KoljaWindeler/CHIP_SALSA/README.md

please go to 
http://koljawindeler.github.io/CHIP_SALSA
