KoljaWindeler/CHIP_SALSA/schematics/3_Salsa_II_v3c/BOM.csv

Part/Designator | Manufacture Part Number/Seeed SKU | Quantity
u1 | atmega328p-au | 1
C1,C2,C3,C5,C12 | 08055C104KAT2A | 5
C4 | GRM32DR71E106KA12L | 1
D1,D2,D3 | ES2D | 3
LED1 | WS2812B | 1
Q2,Q3,Q4,Q5 | DMN6068SE-13 | 4
R1 | CRCW080510K0FKEA | 1
IC1 | aaL293DD | 1
LED2 | aa150080BS75000 | 1
IC2 | aa74HCT04D | 1
