KoljaWindeler/CHIP_SALSA/(threads)

Thread 1 (2016-08-13):

memory leak in firmware

TobbeJ, 2016-08-13:
there is a memory leak in the firmware that can cause the firmware to stop functioning properly.
see line: https://github.com/KoljaWindeler/CHIP_SALSA/blob/master/firmware/atmega328/atmega328.ino#L200
this pointer is never deleted.

so if you spam multiple config requests for a ws2812 pin eventually the firmware will run out of ram and bad things will happen.
