KoljaWindeler/CHIP_SALSA/schematics/3_Salsa_II_v3c/salsa_II_v3c_bot.pdf

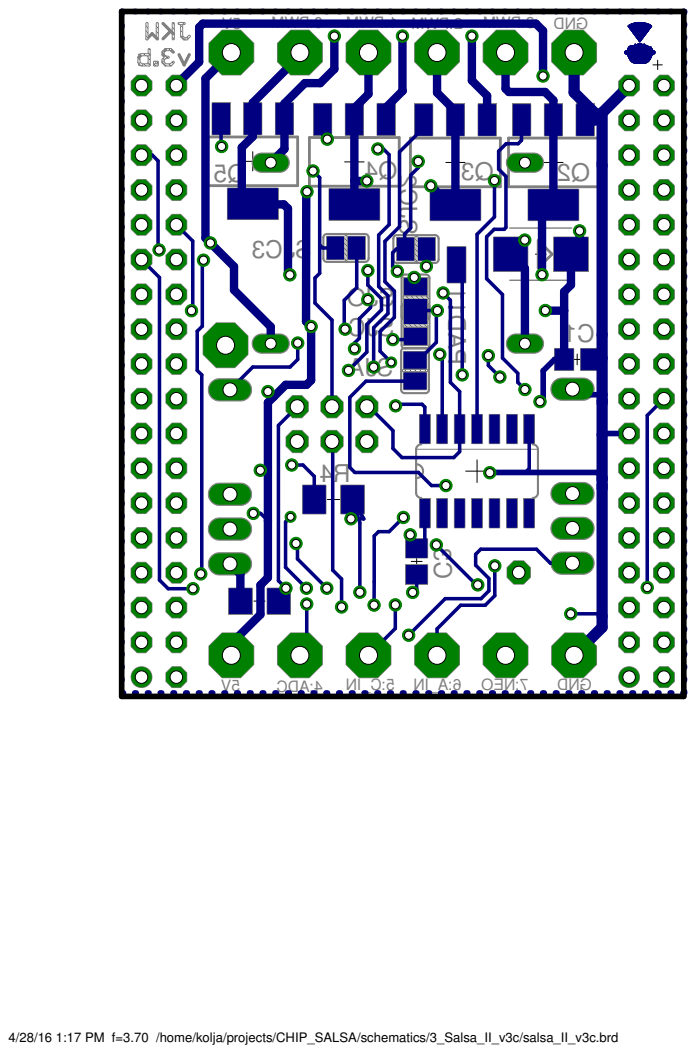
[picture p8: page 1]

4/28/16 1:17 PM f=3.70 /home/kolja/projects/CHIP_SALSA/schematics/3_Salsa_II_v3c/salsa_II_v3c.brd
