KoljaWindeler/CHIP_SALSA/schematics/3_Salsa_II_v3c/salsa_II_v3c_sch.pdf

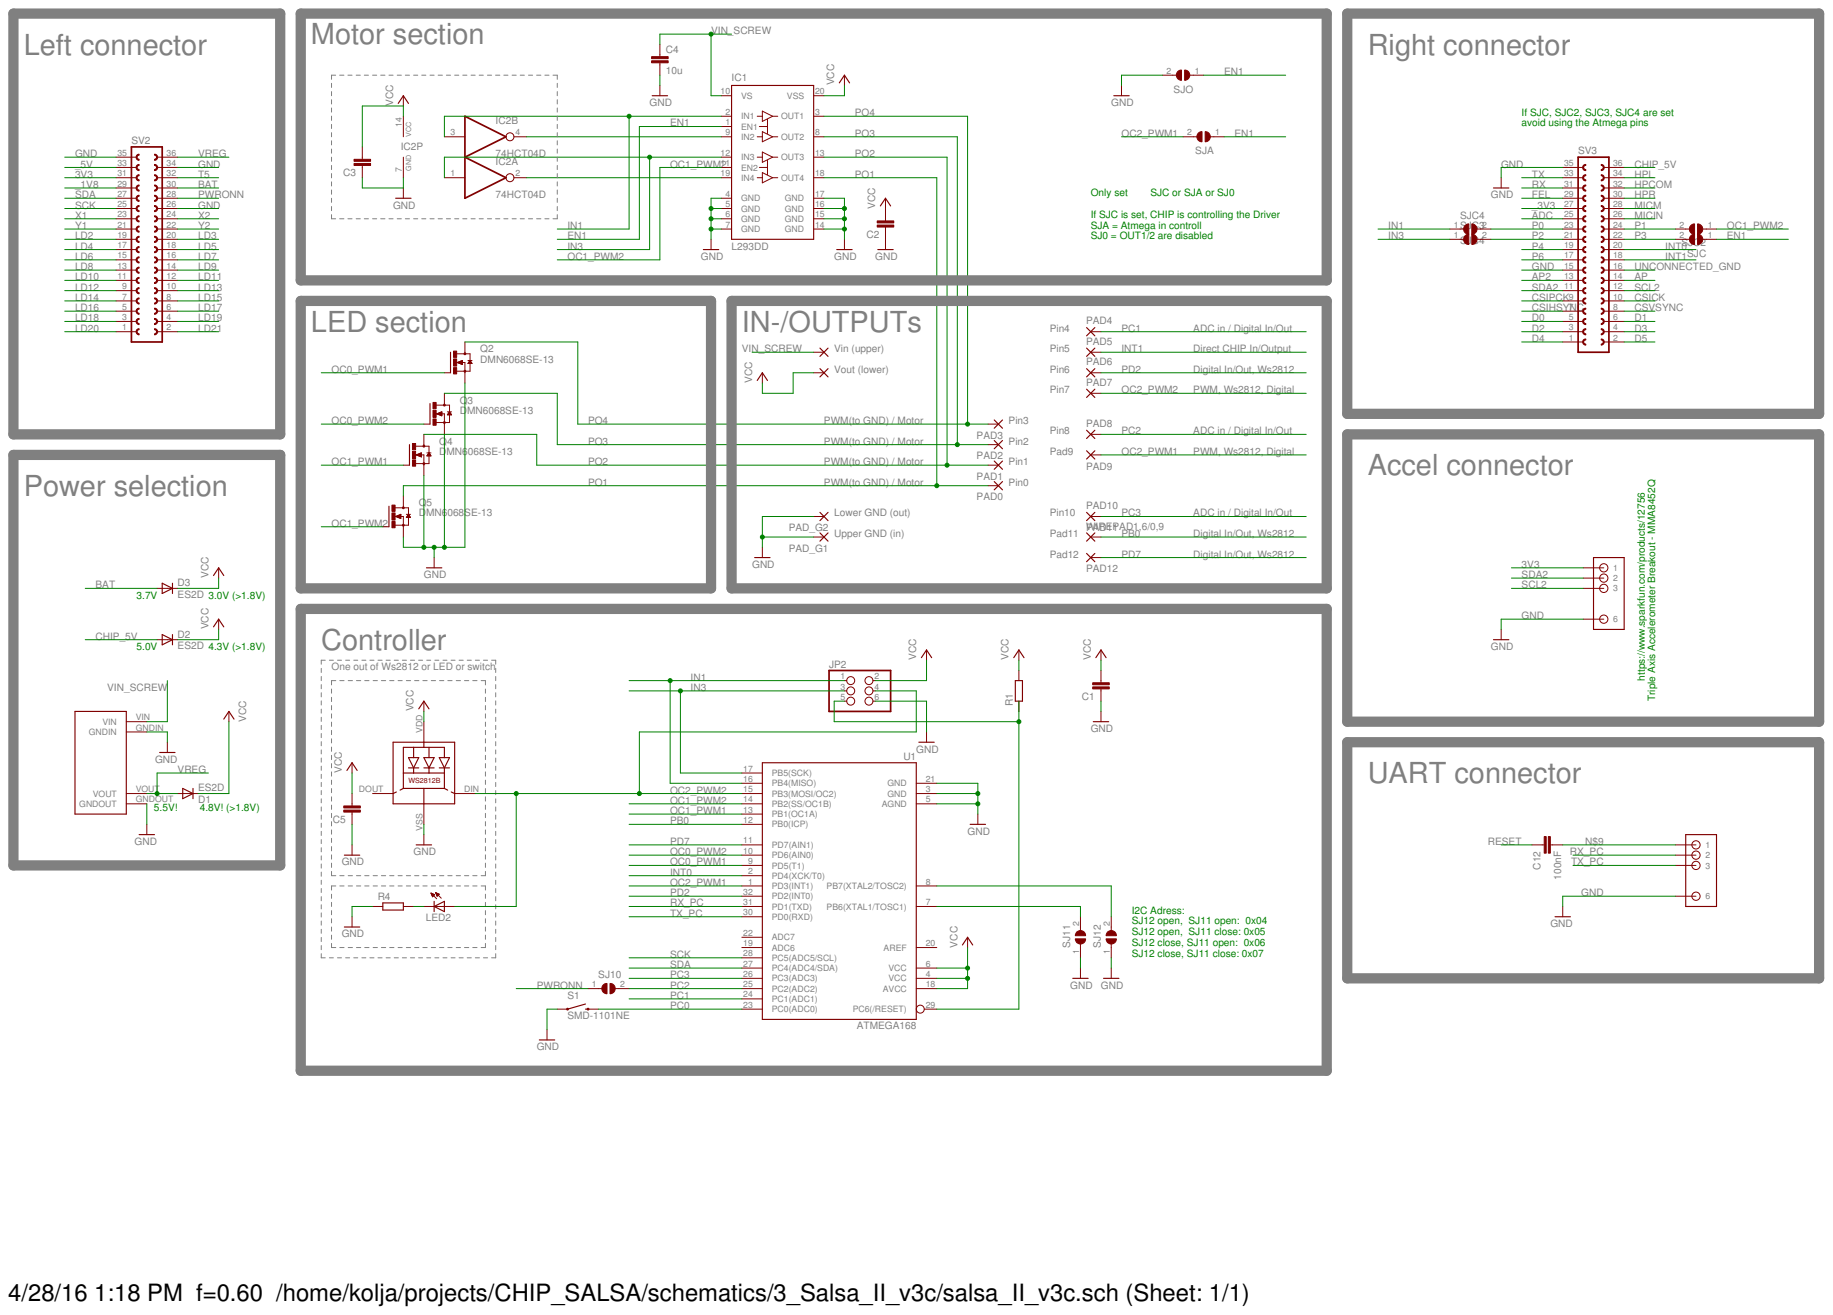
[picture p9: page 1]

If SJC, SJC2, SJC3, SJC4 are set avoid using the Atmega pins

If SJC is set, CHIP is controlling the Driver SJA = Atmega in controll SJ0 = OUT1/2 are disabled

ADC in / Digital In/Out
Direct CHIP In/Output Digital In/Out, Ws2812 PWM, Ws2812, Digital

ADC in / Digital In/Out PWM, Ws2812, Digital

https:/ www.sparkfun.com/products/12756 Triple Axis Accelerometer Breakout - MMA8452Q

Upper GND (in) Lower GND (out)

Digital In/Out, Ws2812

One out of Ws2812 or LED or switch

I2C Adress: SJ12 open, SJ11 open: 0x04 SJ12 open, SJ11 close: 0x05 SJ12 close, SJ11 open: 0x06 SJ12 close, SJ11 close: 0x07

4/28/16 1:18 PM f=0.60 /home/kolja/projects/CHIP_SALSA/schematics/3_Salsa_II_v3c/salsa_II_v3c.sch (Sheet: 1/1)
