KoljaWindeler/CHIP_SALSA/schematics/3_Salsa_II_v3c/salsa_II_v3c.brd

## EAGLE design schematics/3_Salsa_II_v3c/salsa_II_v3c.brd (2016-03-03)

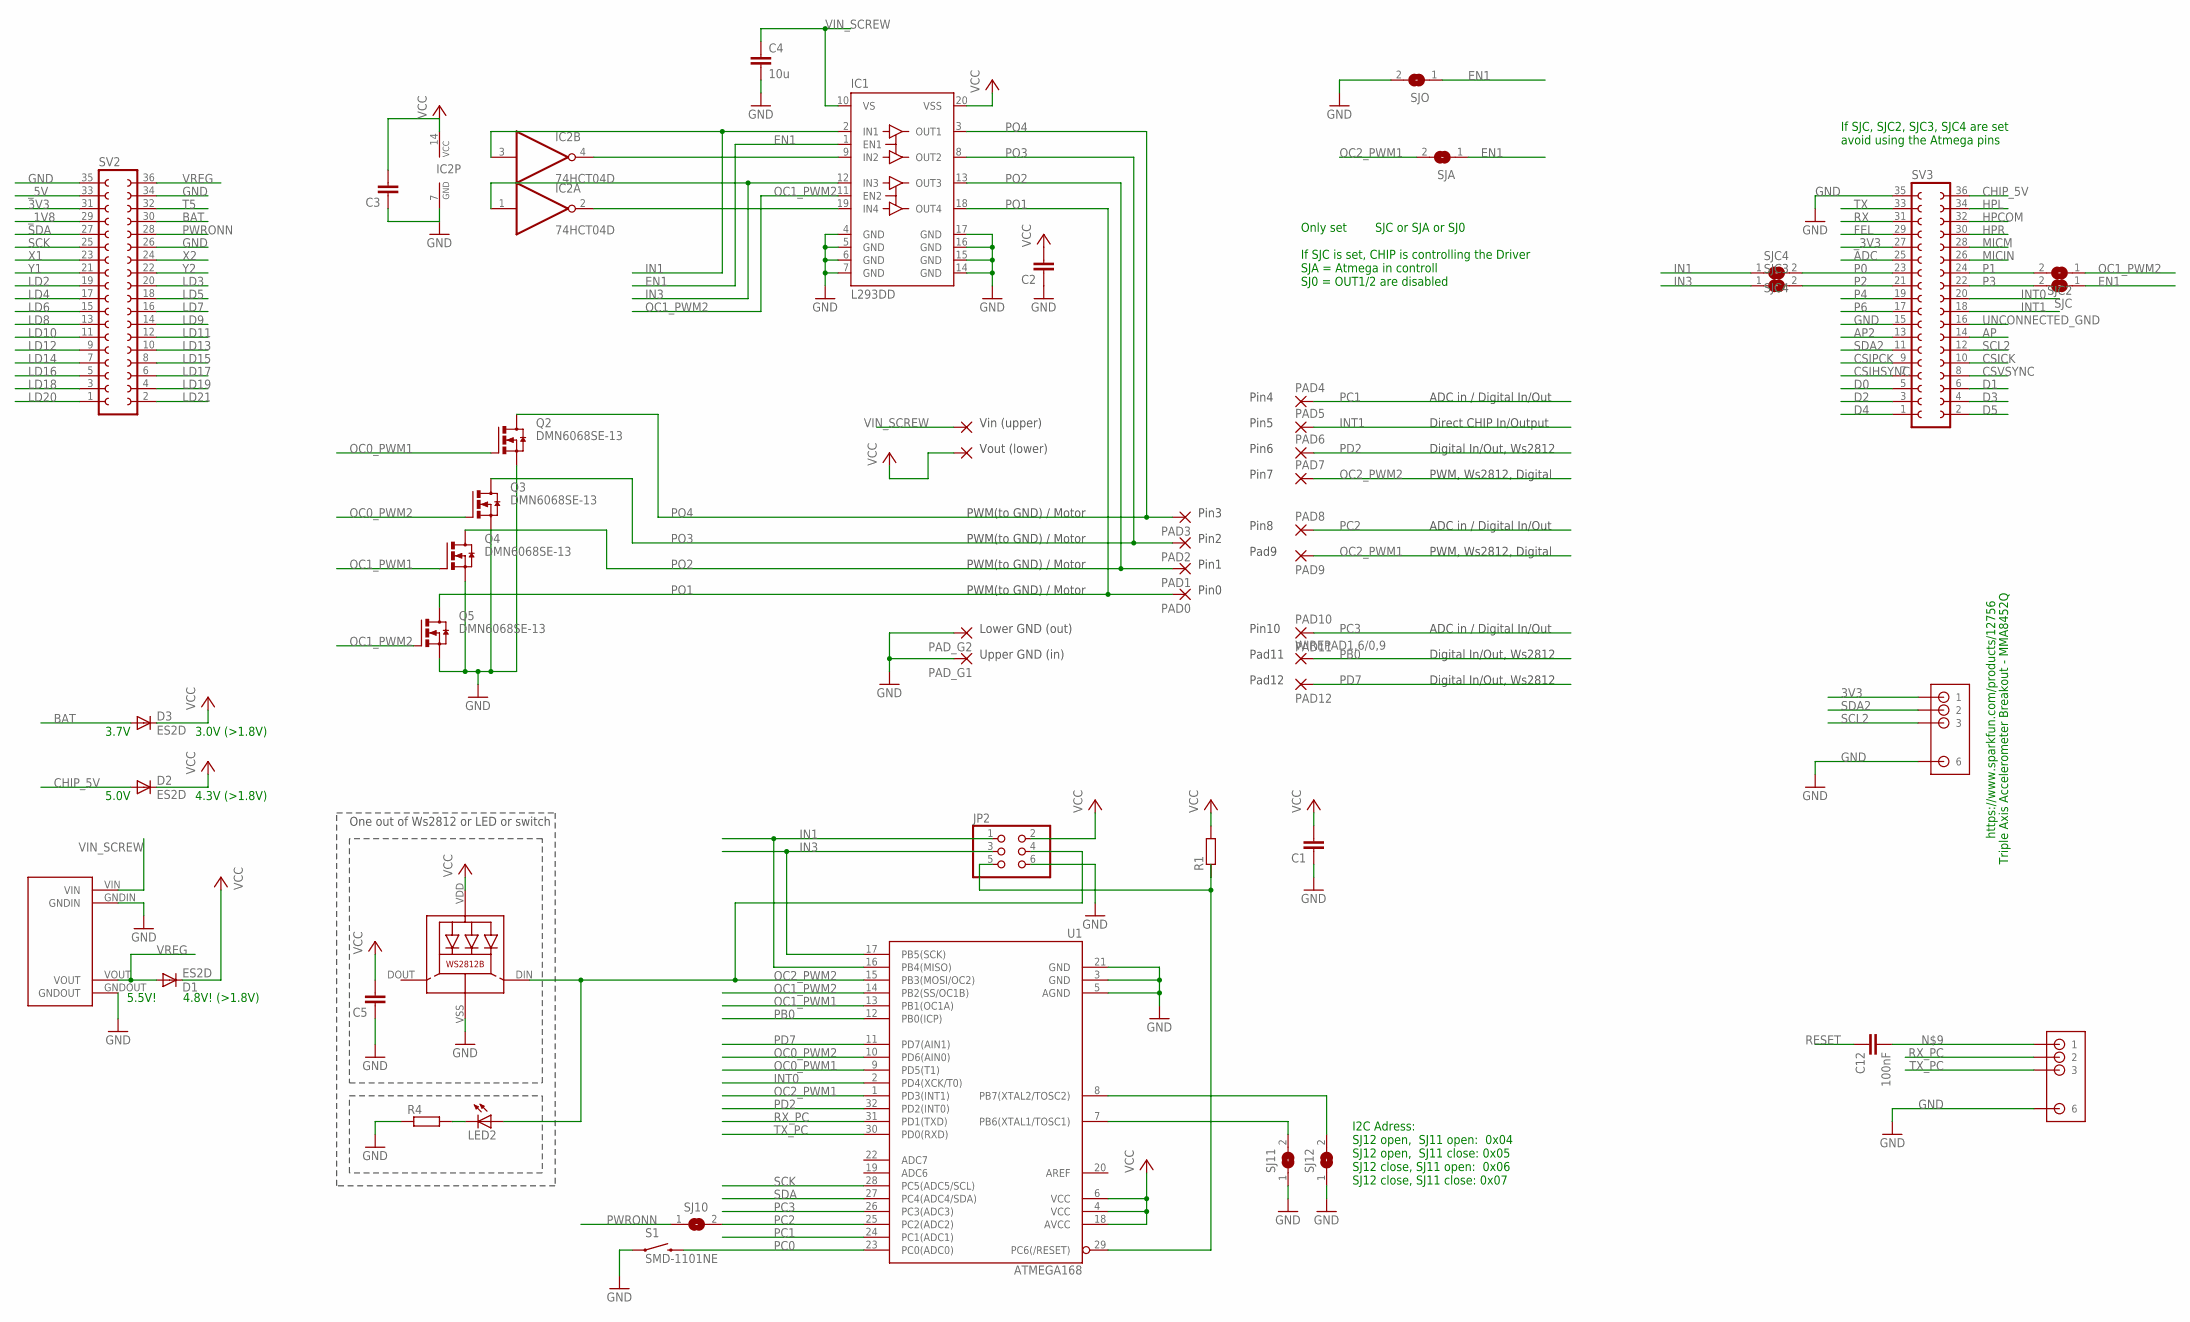
[picture p10: schematic salsa_II_v3c.sch]

Parts:
C1, C2, C3, C5: C-EUC0805; C0805
C4: 10u; C1210
C12: 100nF; C1206
D1, D2, D3: ES2D; SMB
IC1: L293DD; SO20
IC2: 74HCT04D; SO14
JP2: PINHD-2X3; 2X03
LED1: WS2812B
LED2: LEDCHIP-LED0805; CHIP-LED0805
PAD0, PAD1, PAD2, PAD3, PAD4, PAD5, PAD6, PAD7, PAD8, PAD17: 3,17/1,3
PAD9, PAD12: SMD2; SMD1,27-2,54
PAD10: WIREPAD1,6/0,9; 1,6/0,9
PAD11: WIREPADSMD1,27-254; SMD1,27-2,54
PAD_G1, PAD_G2: 3,17/1,3
PAD_VIN: 3,17/1,3
Q2, Q3, Q4, Q5: DMN6068SE-13; SOT223
R1: R-EU_M0805; M0805
R4: R-EU_M1206; M1206
S1: SMD-1101NE; TACTILE-SWITCH-1101NE
SJ10, SJ11, SJ12: SJ
SJA: SJ
SJC, SJC2, SJC3: SJ
SJC4: SJC4; SJ
SJO: SJ
SV2, SV3: FE18-2
U1: ATMEGA168; TQFP32-08
U$1: MP1584EN
U$3, U$4: 6_TO_4_HEADER

Connections:
3V3: SV2.31, U$4.1
ADC: SV3.25
AP: SV3.14
AP2: SV3.13
BAT: D3.A, SV2.30
CHIP_5V: D2.A, SV3.36
CSICK: SV3.10
CSIHSYNC: SV3.7
CSIPCK: SV3.9
CSVSYNC: SV3.8
D0: SV3.5
D1: SV3.6
D2: SV3.3
D3: SV3.4
D4: SV3.1
D5: SV3.2
EN1: IC1.1 (EN1), SJA.1, SJC.1, SJO.1
FEL: SV3.29
GND: C1.1, C2.1, C3.1, C4.2, C5.1, IC1.4 (GND), IC1.5 (GND), IC1.6 (GND), IC1.7 (GND), IC1.14 (GND), IC1.15 (GND), IC1.16 (GND), IC1.17 (GND), IC2.7 (GND), JP2.6, LED1.VSS (GND), PAD_G1.1, PAD_G2.1, Q2.3 (S), Q3.3 (S), Q4.3 (S), Q5.3 (S), R4.1, S1.P$1 (1), SJ11.1, SJ12.1, SJO.2, SV2.26, SV2.34, SV2.35, SV3.15, SV3.35, U1.3 (GND), U1.5 (AGND), U1.21 (GND), U$1.GNDIN, U$1.GNDOUT, U$3.6, U$4.6
HPCOM: SV3.32
HPL: SV3.34
HPR: SV3.30
IN1: IC1.2 (IN1), IC2.3 (I), JP2.1, SJC4.1, U1.16 (PB4(MISO))
IN3: IC1.12 (IN3), IC2.1 (I), JP2.3, SJC3.1, U1.17 (PB5(SCK))
INT0: SV3.20, U1.2 (PD4(XCK/T0))
INT1: PAD5.1, SV3.18
LD2: SV2.19
LD3: SV2.20
LD4: SV2.17
LD5: SV2.18
LD6: SV2.15
LD7: SV2.16
LD8: SV2.13
LD9: SV2.14
LD10: SV2.11
LD11: SV2.12
LD12: SV2.9
LD13: SV2.10
LD14: SV2.7
LD15: SV2.8
LD16: SV2.5
LD17: SV2.6
LD18: SV2.3
LD19: SV2.4
LD20: SV2.1
LD21: SV2.2
MICIN: SV3.26
MICM: SV3.28
unnamed: IC1.19 (IN4), IC2.2 (O)
unnamed: SJ11.2, U1.7 (PB6(XTAL1/TOSC1))
unnamed: SJ12.2, U1.8 (PB7(XTAL2/TOSC2))
unnamed: LED2.C, R4.2
unnamed: C12.2, U$3.1
unnamed: IC1.9 (IN2), IC2.4 (O)
OC0_PWM1: Q2.1 (G), U1.9 (PD5(T1))
OC0_PWM2: Q3.1 (G), U1.10 (PD6(AIN0))
OC1_PWM1: Q4.1 (G), U1.13 (PB1(OC1A))
OC1_PWM2: IC1.11 (EN2), Q5.1 (G), SJC2.1, U1.14 (PB2(SS/OC1B))
OC2_PWM1: PAD9.1, SJA.2, U1.1 (PD3(INT1))
OC2_PWM2: JP2.4, LED1.DIN (DI), LED2.A, PAD7.1, U1.15 (PB3(MOSI/OC2))
P0: SJC4.2, SV3.23
P1: SJC2.2, SV3.24
P2: SJC3.2, SV3.21
P3: SJC.2, SV3.22
P4: SV3.19
P6: SV3.17
PB0: PAD11.1, U1.12 (PB0(ICP))
PC0: S1.P$2 (2), U1.23 (PC0(ADC0))
PC1: PAD4.1, U1.24 (PC1(ADC1))
PC2: PAD8.1, SJ10.2, U1.25 (PC2(ADC2))
PC3: PAD10.1, U1.26 (PC3(ADC3))
PD2: PAD6.1, U1.32 (PD2(INT0))
PD7: PAD12.1, U1.11 (PD7(AIN1))
PO1: IC1.18 (OUT4), PAD0.1, Q5.2 (D), Q5.4 (D)
PO2: IC1.13 (OUT3), PAD1.1, Q4.2 (D), Q4.4 (D)
PO3: IC1.8 (OUT2), PAD2.1, Q3.2 (D), Q3.4 (D)
PO4: IC1.3 (OUT1), PAD3.1, Q2.2 (D), Q2.4 (D)
PWRONN: SJ10.1, SV2.28
RESET: C12.1, JP2.5, R1.1, U1.29 (PC6(/RESET))
RX: SV3.31
RX_PC: U1.31 (PD1(TXD)), U$3.2
SCK: SV2.25, U1.28 (PC5(ADC5/SCL))
SCL2: SV3.12, U$4.3
SDA: SV2.27, U1.27 (PC4(ADC4/SDA))
SDA2: SV3.11, U$4.2
T5: SV2.32
TX: SV3.33
TX_PC: U1.30 (PD0(RXD)), U$3.3
UNCONNECTED_GND: SV3.16
VCC: C1.2, C2.2, C3.2, C5.2, D1.C, D2.C, D3.C, IC1.20 (VSS), IC2.14 (VCC), JP2.2, LED1.VDD, PAD17.1, R1.2, U1.4 (VCC), U1.6 (VCC), U1.18 (AVCC)
VIN_SCREW: C4.1, IC1.10 (VS), PAD_VIN.1, U$1.VIN
VREG: D1.A, SV2.36, U$1.VOUT
X1: SV2.23
X2: SV2.24
Y1: SV2.21
Y2: SV2.22
_1V8: SV2.29
_3V3: SV3.27
_5V: SV2.33

Notes on the sheet:
https://www.sparkfun.com/products/12756
Triple Axis Accelerometer Breakout - MMA8452Q
Vin (upper)
Pin0
Pin1
Pin2
Pin3
Upper GND (in)
Lower GND (out)
Vout (lower)
Pin4
Pin5
Pad11
Pad12
Pad9
Pin6
Pin7
Pin8
Pin10
PWM(to GND) / Motor
ADC in / Digital In/Out
Direct CHIP In/Output
Digital In/Out, Ws2812
PWM, Ws2812, Digital
I2C Adress: SJ12 open, SJ11 open: 0x04 SJ12 open, SJ11 close: 0x05 SJ12 close, SJ11 open: 0x06 SJ12 close, SJ11 close: 0x07
Only set SJC or SJA or SJ0 If SJC is set, CHIP is controlling the Driver SJA = Atmega in controll SJ0 = OUT1/2 are disabled
If SJC, SJC2, SJC3, SJC4 are set avoid using the Atmega pins
One out of Ws2812 or LED or switch
5.5V!
4.8V! (>1.8V)
5.0V
4.3V (>1.8V)
3.0V (>1.8V)
3.7V

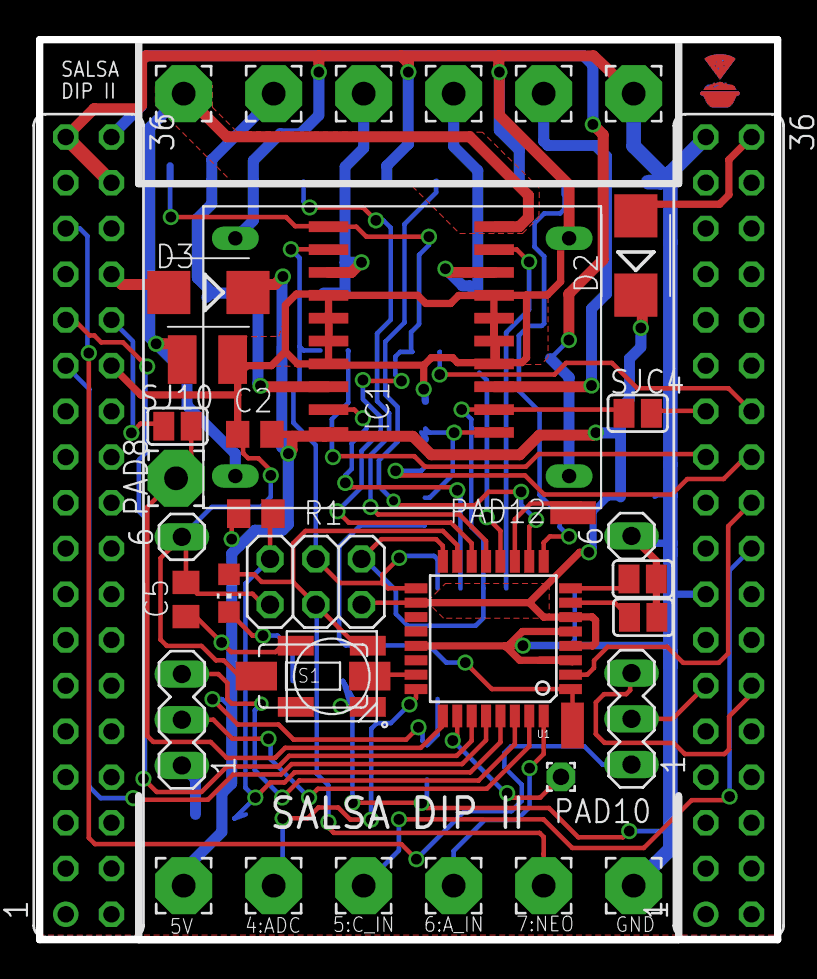
[picture p11: board salsa_II_v3c.brd from above]

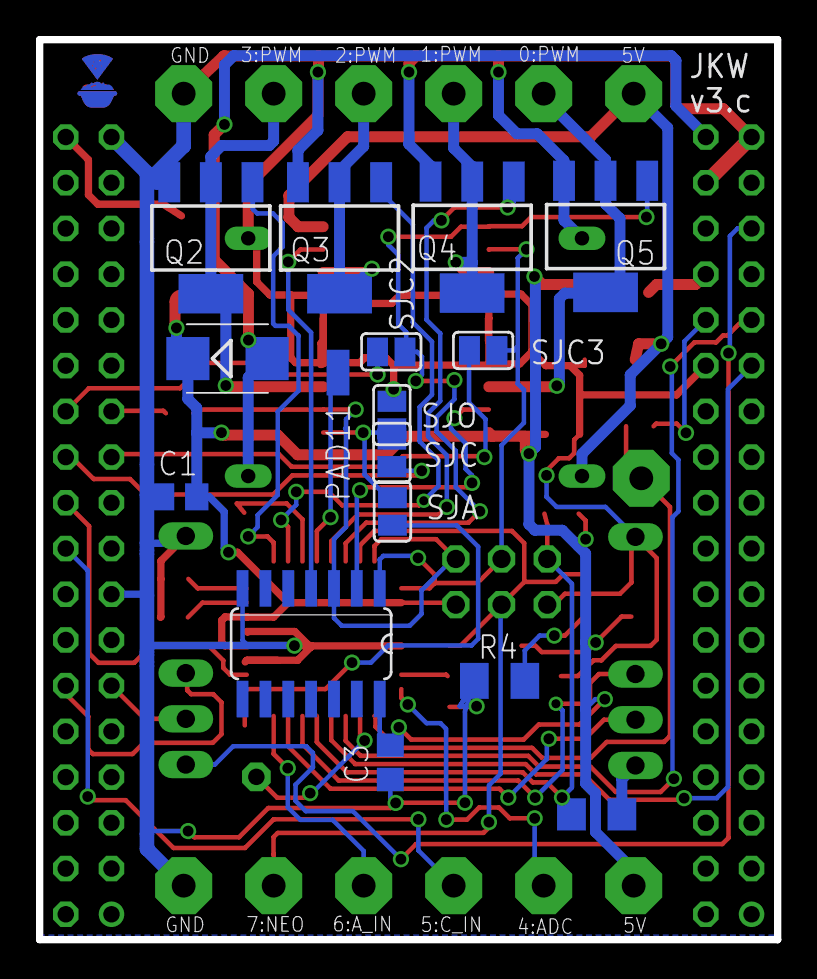
[picture p12: board salsa_II_v3c.brd from below]

Board: 2 copper layers, 41.0 x 50.0 mm, 55 parts (17 on the bottom side), 47 nets.

Other parts of the board:
U$2, U$5: LOGO
