KoljaWindeler/CHIP_SALSA/schematics/dev_versions/dev_v7/shield_v7.brd

## EAGLE design schematics/dev_versions/dev_v7/shield_v7.brd (2016-02-05, an earlier design)

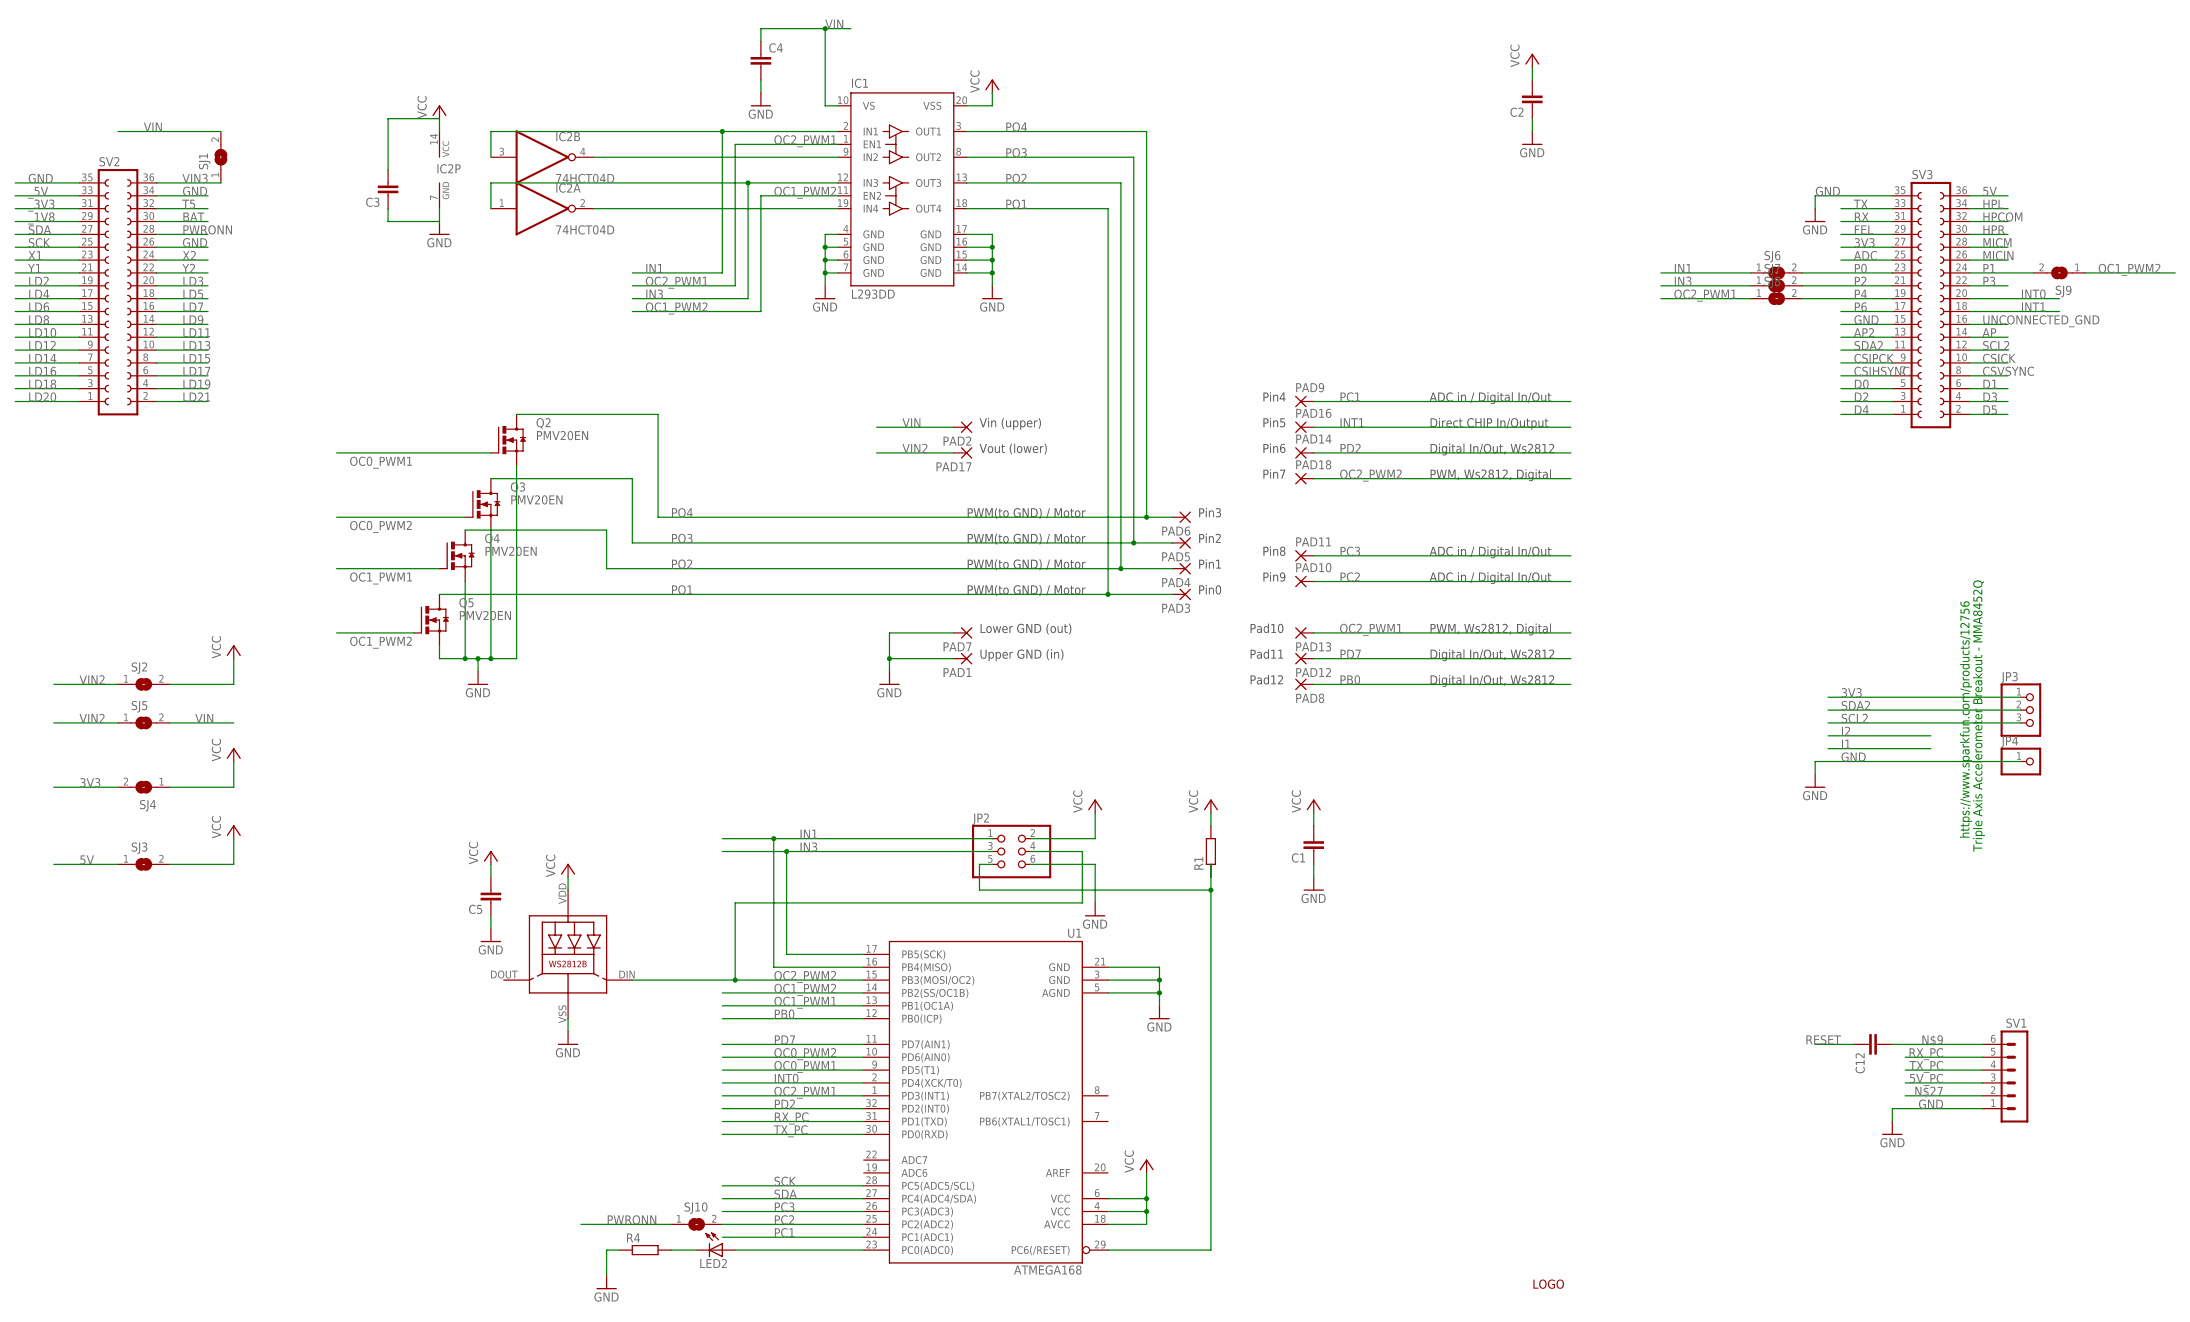
[picture p13: schematic shield_v7.sch]

Parts:
C1, C2, C3, C5: C-EUC0805; C0805
C4: C-EUC1210; C1210
C12: C-EUC1206; C1206
IC1: L293DD; SO20
IC2: 74HCT04D; SO14
JP2: PINHD-2X3; 2X03
JP3: PINHD-1X3; 1X03
JP4: PINHD-1X1; 1X01
LED1: WS2812B
LED2: LEDCHIP-LED0805; CHIP-LED0805
PAD1, PAD2, PAD3, PAD4, PAD5, PAD6, PAD7, PAD9, PAD10, PAD11, PAD14, PAD16, PAD17, PAD18: 3,17/1,3
PAD8: WIREPADSMD1,27-254; SMD1,27-2,54
PAD12, PAD13: SMD2; SMD1,27-2,54
Q2, Q3, Q4, Q5: PMV20EN; SOT223
R1, R4: R-EU_M1206; M1206
SJ1, SJ2, SJ3, SJ4, SJ5, SJ6, SJ7, SJ8, SJ9, SJ10: SJ
SV1: MA06-1
SV2, SV3: FE18-2
U1: ATMEGA168; TQFP32-08
U$2: LOGO

Connections:
3V3: JP3.1, SJ4.2, SV3.27
5V: SJ3.1, SV3.36
5V_PC: SV1.3
ADC: SV3.25
AP: SV3.14
AP2: SV3.13
BAT: SV2.30
CSICK: SV3.10
CSIHSYNC: SV3.7
CSIPCK: SV3.9
CSVSYNC: SV3.8
D0: SV3.5
D1: SV3.6
D2: SV3.3
D3: SV3.4
D4: SV3.1
D5: SV3.2
FEL: SV3.29
GND: C1.1, C2.1, C3.1, C4.2, C5.1, IC1.4 (GND), IC1.5 (GND), IC1.6 (GND), IC1.7 (GND), IC1.14 (GND), IC1.15 (GND), IC1.16 (GND), IC1.17 (GND), IC2.7 (GND), JP2.6, JP4.1, LED1.VSS (GND), PAD1.1, PAD7.1, Q2.3 (S), Q3.3 (S), Q4.3 (S), Q5.3 (S), R4.1, SV1.1, SV2.26, SV2.34, SV2.35, SV3.15, SV3.35, U1.3 (GND), U1.5 (AGND), U1.21 (GND)
HPCOM: SV3.32
HPL: SV3.34
HPR: SV3.30
IN1: IC1.2 (IN1), IC2.3 (I), JP2.1, SJ6.1, U1.16 (PB4(MISO))
IN3: IC1.12 (IN3), IC2.1 (I), JP2.3, SJ7.1, U1.17 (PB5(SCK))
INT0: SV3.20, U1.2 (PD4(XCK/T0))
INT1: PAD16.1, SV3.18
LD2: SV2.19
LD3: SV2.20
LD4: SV2.17
LD5: SV2.18
LD6: SV2.15
LD7: SV2.16
LD8: SV2.13
LD9: SV2.14
LD10: SV2.11
LD11: SV2.12
LD12: SV2.9
LD13: SV2.10
LD14: SV2.7
LD15: SV2.8
LD16: SV2.5
LD17: SV2.6
LD18: SV2.3
LD19: SV2.4
LD20: SV2.1
LD21: SV2.2
MICIN: SV3.26
MICM: SV3.28
unnamed: IC1.19 (IN4), IC2.2 (O)
unnamed: C12.2, SV1.6
unnamed: IC1.9 (IN2), IC2.4 (O)
unnamed: LED2.C, R4.2
unnamed: LED2.A, U1.23 (PC0(ADC0))
OC0_PWM1: Q2.1 (G), U1.9 (PD5(T1))
OC0_PWM2: Q3.1 (G), U1.10 (PD6(AIN0))
OC1_PWM1: Q4.1 (G), U1.13 (PB1(OC1A))
OC1_PWM2: IC1.11 (EN2), Q5.1 (G), SJ9.1, U1.14 (PB2(SS/OC1B))
OC2_PWM1: IC1.1 (EN1), PAD13.1, SJ8.1, U1.1 (PD3(INT1))
OC2_PWM2: JP2.4, LED1.DIN (DI), PAD18.1, U1.15 (PB3(MOSI/OC2))
P0: SJ6.2, SV3.23
P1: SJ9.2, SV3.24
P2: SJ7.2, SV3.21
P3: SV3.22
P4: SJ8.2, SV3.19
P6: SV3.17
PB0: PAD8.1, U1.12 (PB0(ICP))
PC1: PAD9.1, U1.24 (PC1(ADC1))
PC2: PAD10.1, SJ10.2, U1.25 (PC2(ADC2))
PC3: PAD11.1, U1.26 (PC3(ADC3))
PD2: PAD14.1, U1.32 (PD2(INT0))
PD7: PAD12.1, U1.11 (PD7(AIN1))
PO1: IC1.18 (OUT4), PAD3.1, Q5.2 (D), Q5.4 (D)
PO2: IC1.13 (OUT3), PAD4.1, Q4.2 (D), Q4.4 (D)
PO3: IC1.8 (OUT2), PAD5.1, Q3.2 (D), Q3.4 (D)
PO4: IC1.3 (OUT1), PAD6.1, Q2.2 (D), Q2.4 (D)
PWRONN: SJ10.1, SV2.28
RESET: C12.1, JP2.5, R1.1, U1.29 (PC6(/RESET))
RX: SV3.31
RX_PC: SV1.5, U1.31 (PD1(TXD))
SCK: SV2.25, U1.28 (PC5(ADC5/SCL))
SCL2: JP3.3, SV3.12
SDA: SV2.27, U1.27 (PC4(ADC4/SDA))
SDA2: JP3.2, SV3.11
T5: SV2.32
TX: SV3.33
TX_PC: SV1.4, U1.30 (PD0(RXD))
UNCONNECTED_GND: SV3.16
VCC: C1.2, C2.2, C3.2, C5.2, IC1.20 (VSS), IC2.14 (VCC), JP2.2, LED1.VDD, R1.2, SJ2.2, SJ3.2, SJ4.1, U1.4 (VCC), U1.6 (VCC), U1.18 (AVCC)
VIN: C4.1, IC1.10 (VS), PAD2.1, SJ1.2, SJ5.2
VIN2: PAD17.1, SJ2.1, SJ5.1
VIN3: SJ1.1, SV2.36
X1: SV2.23
X2: SV2.24
Y1: SV2.21
Y2: SV2.22
_1V8: SV2.29
_3V3: SV2.31
_5V: SV2.33

Notes on the sheet:
https://www.sparkfun.com/products/12756
Triple Axis Accelerometer Breakout - MMA8452Q
Vin (upper)
Pin0
Pin1
Pin2
Pin3
Upper GND (in)
Lower GND (out)
Vout (lower)
Pin4
Pin5
Pad12
Pad11
Pad10
Pin6
Pin7
Pin9
Pin8
PWM(to GND) / Motor
ADC in / Digital In/Out
Direct CHIP In/Output
Digital In/Out, Ws2812
PWM, Ws2812, Digital

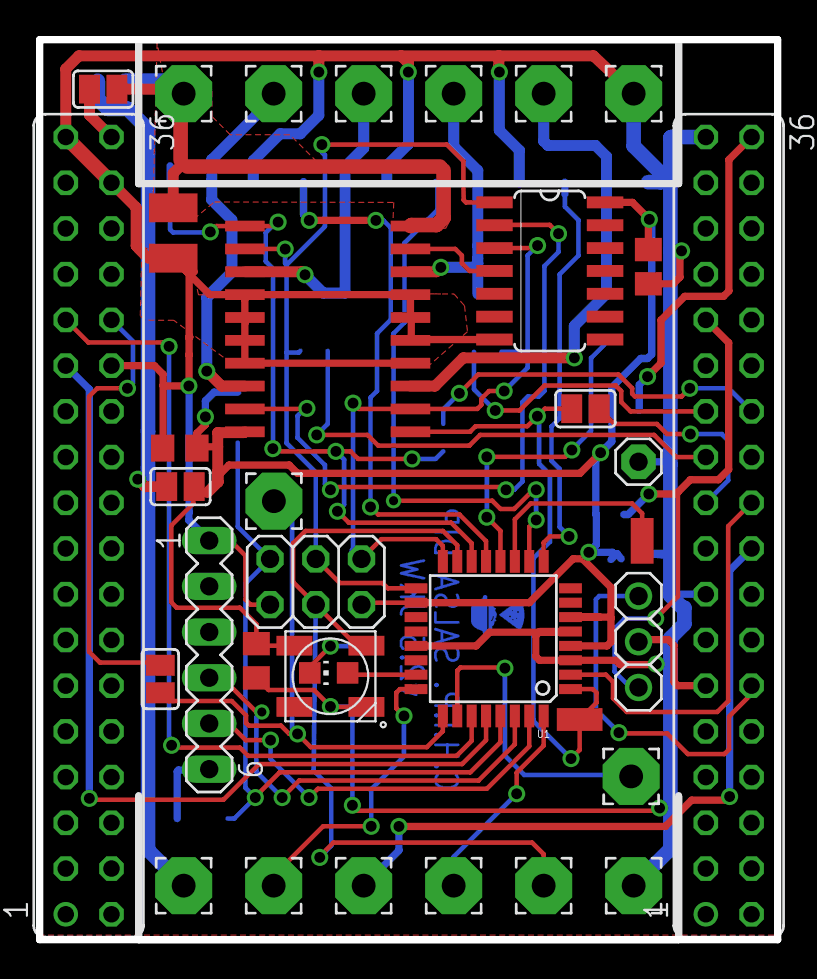
[picture p14: board shield_v7.brd from above]

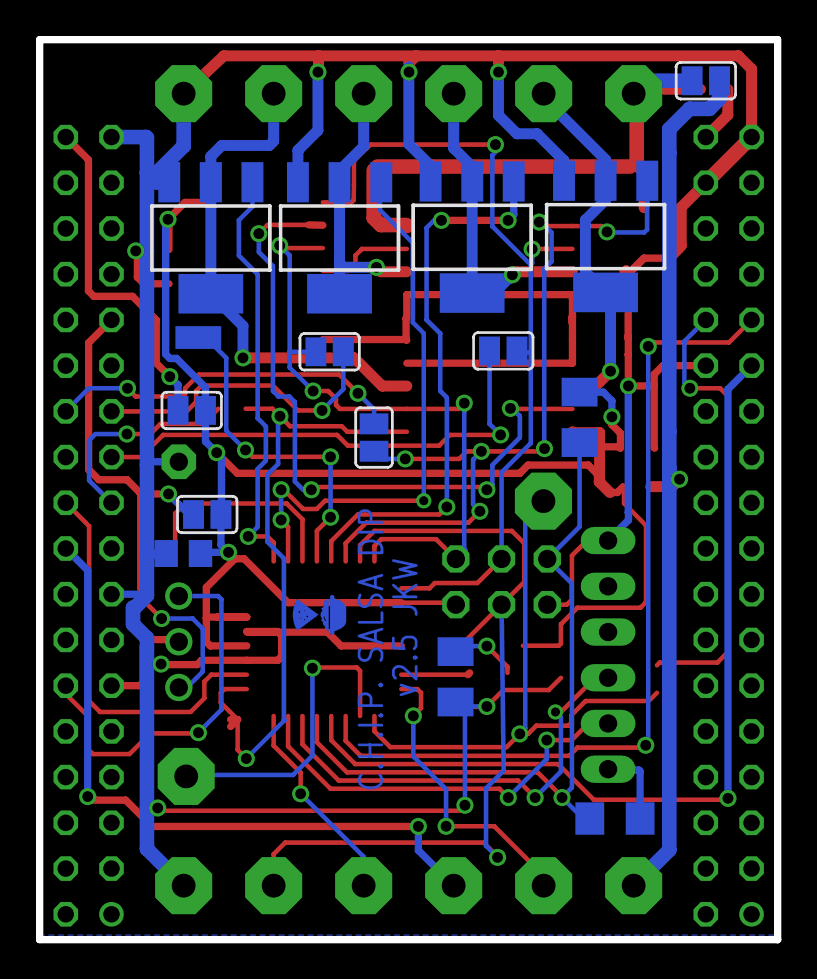
[picture p15: board shield_v7.brd from below]

Board: 2 copper layers, 41.0 x 50.0 mm, 51 parts (15 on the bottom side), 44 nets.
