KoljaWindeler/CHIP_SALSA/schematics/dev_versions/dev_v1/shield.brd

## EAGLE design schematics/dev_versions/dev_v1/shield.brd (2016-01-03, an earlier design)

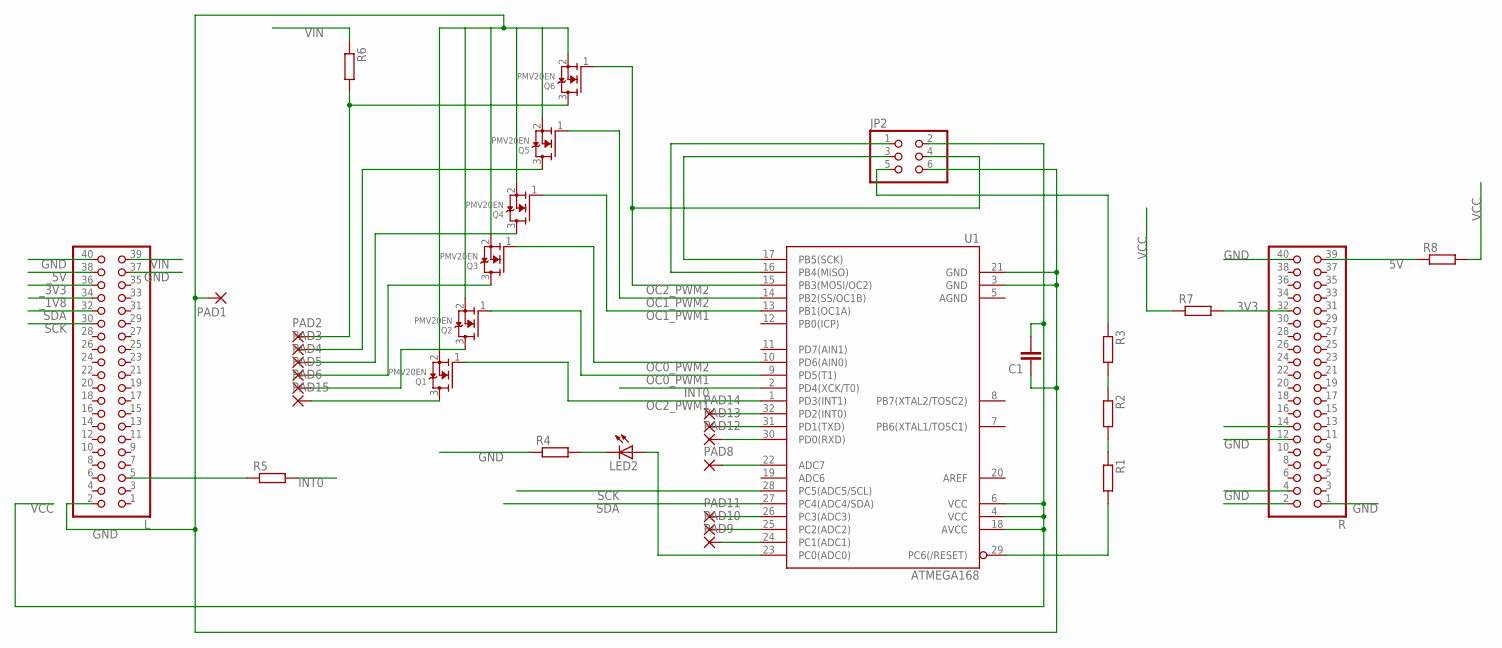
[picture p16: schematic shield.sch]

Parts:
C1: C-EUC0805; C0805
JP2: PINHD-2X3; 2X03
L: PINHD-2X20; 2X20
LED2: LEDCHIP-LED0805; CHIP-LED0805
PAD1, PAD2, PAD3, PAD4, PAD5, PAD6, PAD8, PAD9, PAD10, PAD11, PAD12, PAD13, PAD14, PAD15: 2,54/0,9
Q1, Q2, Q3, Q4, Q5, Q6: PMV20EN; SOT23
R: PINHD-2X20; 2X20
R1, R2, R3, R4, R5, R6: R-EU_M1206; M1206
R7, R8: R-EU_M0805; M0805
U1: ATMEGA168; TQFP32-08

Connections:
3V3: R.32, R7.2
5V: R.39, R8.1
GND: C1.1, JP2.6, L.2, L.37, L.40, PAD1.1, Q1.2 (S), Q2.2 (S), Q3.2 (S), Q4.2 (S), Q5.2 (S), Q6.2 (S), R.1, R.4, R.12, R.40, R4.1, U1.3 (GND), U1.21 (GND)
INT0: R5.2, U1.2 (PD4(XCK/T0))
unnamed: R1.2, U1.29 (PC6(/RESET))
unnamed: JP2.1, U1.16 (PB4(MISO))
unnamed: JP2.3, U1.17 (PB5(SCK))
unnamed: PAD15.1, Q1.3 (D)
unnamed: PAD6.1, Q2.3 (D)
unnamed: PAD5.1, Q3.3 (D)
unnamed: PAD4.1, Q4.3 (D)
unnamed: PAD3.1, Q5.3 (D)
unnamed: PAD2.1, Q6.3 (D), R6.2
unnamed: JP2.5, R3.1
unnamed: PAD12.1, U1.30 (PD0(RXD))
unnamed: PAD13.1, U1.31 (PD1(TXD))
unnamed: PAD14.1, U1.32 (PD2(INT0))
unnamed: PAD8.1, U1.22 (ADC7)
unnamed: PAD9.1, U1.24 (PC1(ADC1))
unnamed: PAD10.1, U1.25 (PC2(ADC2))
unnamed: PAD11.1, U1.26 (PC3(ADC3))
unnamed: R1.1, R2.2
unnamed: R2.1, R3.2
unnamed: LED2.C, R4.2
unnamed: L.5, R5.1
unnamed: LED2.A, U1.23 (PC0(ADC0))
OC0_PWM1: Q2.1 (G), U1.9 (PD5(T1))
OC0_PWM2: Q3.1 (G), U1.10 (PD6(AIN0))
OC1_PWM1: Q4.1 (G), U1.13 (PB1(OC1A))
OC1_PWM2: Q5.1 (G), U1.14 (PB2(SS/OC1B))
OC2_PWM1: Q1.1 (G), U1.1 (PD3(INT1))
OC2_PWM2: JP2.4, Q6.1 (G), U1.15 (PB3(MOSI/OC2))
SCK: L.30, U1.28 (PC5(ADC5/SCL))
SDA: L.32, U1.27 (PC4(ADC4/SDA))
VCC: C1.2, JP2.2, R7.1, R8.2, U1.4 (VCC), U1.6 (VCC), U1.18 (AVCC)
VIN: L.39, R6.1
_1V8: L.34
_3V3: L.36
_5V: L.38

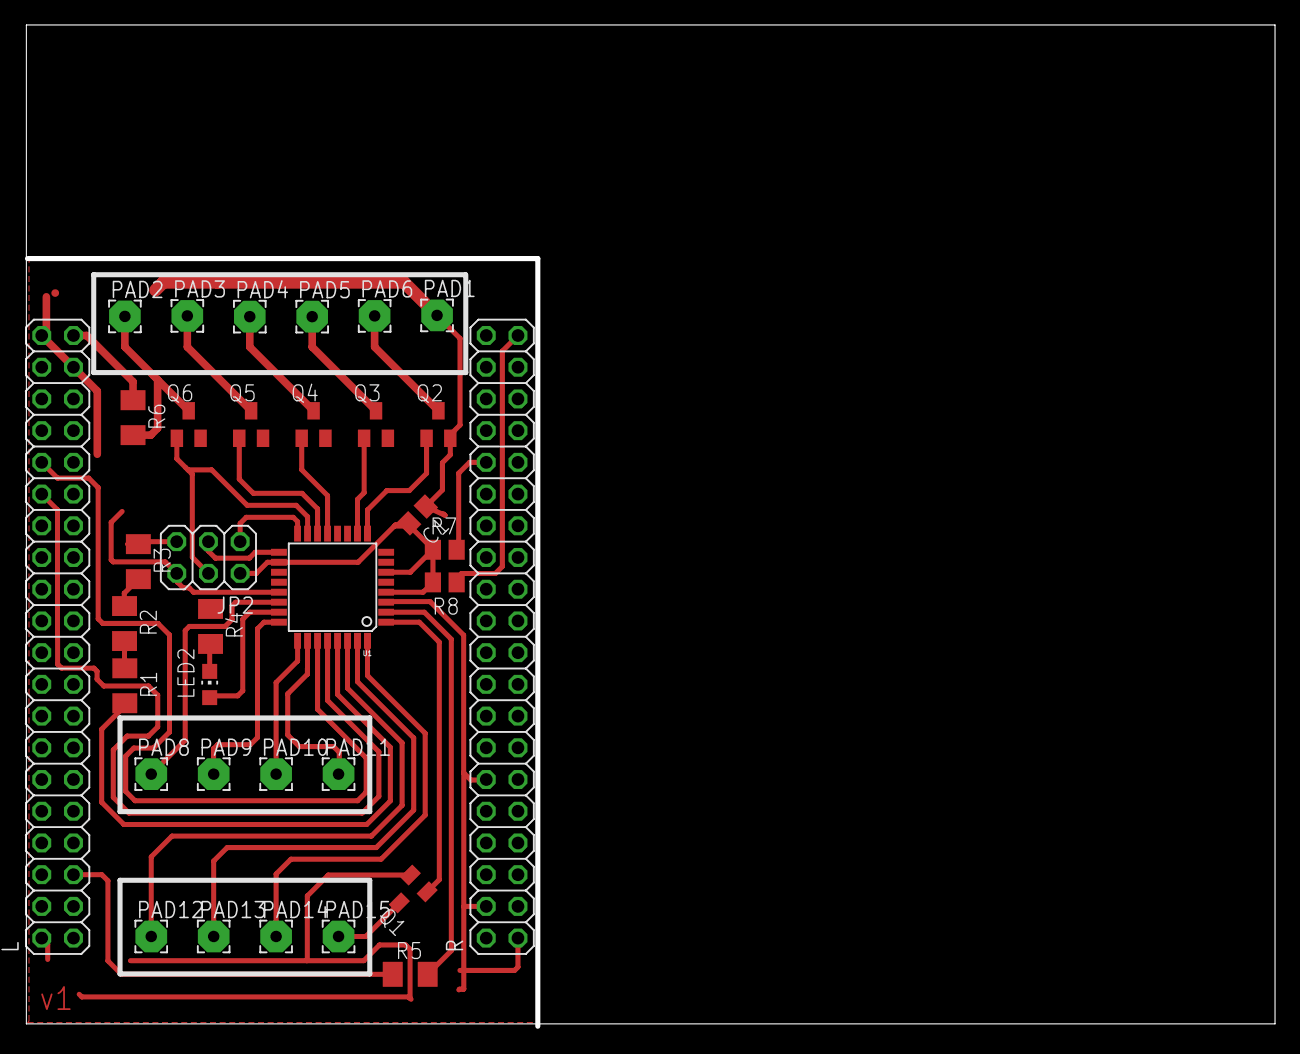
[picture p17: board shield.brd from above]

Board: 2 copper layers, 100.0 x 80.0 mm, 34 parts (0 on the bottom side), 36 nets.
