KoljaWindeler/CHIP_SALSA/python/lib_set_digital.py

import time
import arduino_bridge

pin=1

arduino = arduino_bridge.connection()
arduino.setup_digital_output(pin)

while(1):
	arduino.digitalWrite(pin,1)
	print("GPIO pin "+str(pin)+" set HIGH")
	time.sleep(1)
	arduino.digitalWrite(pin,0)
	print("GPIO pin "+str(pin)+" set HIGH")
	time.sleep(1)
