KoljaWindeler/CHIP_SALSA/(commit log)

2016-01-03 added 3.3/5V, a chargin pin and fixed chip layout
    [shield.brd, shield.sch]
2016-01-14 added all leds one color
2016-01-14 removed pin 12 from ws2812, N-Mosfet will avoid Ws2812 cmds
2016-01-15 multi ws2812 support
    [shield.brd, shield.sch]
2016-01-19 added reset cap
    [shield_v3.brd, shield_v3.sch]
2016-01-25 added i2c lib install script
2016-01-25 Added jumper to drive atmega via Vin or CHIP 5V or CHIP3.3V
    [shield_v3.brd, shield_v3.sch]
2016-01-26 first round of fixes
    [arduino_bridge.py, lib_analog_read.py, lib_set_digital.py, lib_ws2812_rainbow.py]
2016-01-26 added todos as reminder for new board
2016-01-26 fixed poor man rainbow to full 3*255 colors
    [lib_ws2812_rainbow.py]
2016-01-27 added the motor driver and inverter to the pwm shield
    [shield_v4.brd, shield_v4.sch]
2016-01-29 added version 2.2 with solder jumper from CHIP GPIO to Motor driver
    [shield_v5.brd, shield_v5.sch]
2016-01-29 updated routing
    [shield_v5.brd]
2016-01-31 copied digital pin settings to arduino file
2016-01-31 rerouting to fix osh DRU issues
    [shield_v5.brd]
2016-01-31 cleaned schematics
    [shield_v5.brd, shield_v5.sch]
2016-01-31 added order note
    [shield_v4.brd]
2016-02-01 added salsa v6 with 10mil wire
    [shield_v6.brd, shield_v6.sch]
2016-02-04 added logo
    [shield_v7.brd, shield_v7.sch]
2016-02-05 moved motor driver lower
    [shield_v7.GBL, shield_v7.GBO, shield_v7.GBP, shield_v7.GBS, shield_v7.GTL, shield_v7.GTO, shield_v7.GTP, shield_v7.GTS]
2016-02-08 added micro usb connector
    [shield_v8.brd, shield_v8.sch]
2016-02-09 added adress selector
    [shield_v9.brd, shield_v9.sch]
2016-02-09 corrected for pinout v2.7
    [arduino_bridge.py]
2016-02-11 not working but shorter
    [PINS.cpp, PINS.h]
2016-02-11 added gerber files for ordered version
    [shield_v9.GBL, shield_v9.GBO, shield_v9.GBP, shield_v9.GBS, shield_v9.GTL, shield_v9.GTO, shield_v9.GTP, shield_v9.GTS]
2016-02-11 newer shorter nicer version running
    [PINS.cpp, atmega328.ino]
2016-02-18 added pinout for LED and motor shield, seeedstudio version
2016-02-24 renamed versions
    [shield.brd, shield.sch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]
2016-02-24 removed copies
    [shield.brd, shield.sch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]
2016-02-24 added step down
    [shield_v9.GBL, shield_v9.GBO, shield_v9.GBP, shield_v9.GBS, shield_v9.GTL, shield_v9.GTO, shield_v9.GTP, shield_v9.GTS]
2016-02-24 Added power supply lib
2016-03-02 added salsa II board, ordered at seeedstudio today
    [salsa_II_v3a.GBL, salsa_II_v3a.GBO, salsa_II_v3a.GBP, salsa_II_v3a.GBS, salsa_II_v3a.GTL, salsa_II_v3a.GTO, salsa_II_v3a.GTP, salsa_II_v3a.GTS]
2016-03-02 cleaned version structure for forum
    [shield.brd, shield.sch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]
2016-03-02 added solder jumper layout for preSalsa board
2016-03-02 added motor solder jumper guide
2016-03-03 added assembled board
    [BOM.csv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]
2016-03-03 moved version 3 to dev as 3b was ordered
    [salsa_II_v3a.GBL, salsa_II_v3a.GBO, salsa_II_v3a.GBP, salsa_II_v3a.GBS, salsa_II_v3a.GTL, salsa_II_v3a.GTO, salsa_II_v3a.GTP, salsa_II_v3a.GTS]
2016-03-03 fixed font
    [salsa_II_v3b.brd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]
2016-03-03 moved fonts to silk
    [BOM.csv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]
2016-03-04 Added pin description and activates more capabilities
2016-03-04 Added motor pins to pinout slide
2016-03-06 added pwm freq setup
2016-03-07 added EL ER DL DR for motor pinout
2016-03-10 added on board led to hdd
2016-03-30 added connection to power pin
2016-04-01 added power safer chart
2017-01-22 added driver test
